ShubhamChinchane/Open-Science-Framework/README.md

# Open-Science-Framework
3D printed open source pipette with 4 nozzles
