ShubhamChinchane/Open-Science-Framework/Bill of materials.odt

Bill of materials

Part No. | Part Name | Quantity | Material | cost | Source
1 | Enclosure | 1 | PLA | 5$ | 3D printing Lab MTU
2 | Main Plunger | 1 | PLA | 4$ | 3D printing Lab MTU
3 | Syringe Holder | 1 | PLA | 5$ | 3D printing Lab MTU
4 | 1ml Syringe | 4 | Disposable plastic | 3.9$ | Allegromedical
5 | Compression Spring | 4 | Stainless steel | 2.5$ | Macmaster
6 | Female adaptor | 4 | Disposable Plastic | 1.8$ | Cole-Parmer Scientific experts
7 | universal pipette tips | 4 | Disposable Plastic | 0.5$ | Amazon
8 | Silicon medical tubing 3/16” OD | 1 foot | Silicon | 1.2$ | Freshwatersystems.com
9 | bolt | 1 | Stainless steel | 0.5$ | Macmaster
10 | Nut | 1 | Stainless steel | 0.5$ | Macmaster
Total cost = 24$

Links

- 1ml Syringe: https://www.allegromedical.com/syringes-c570/syringe-luer-lok-1cc-sp-p550722.html
- Compression Springs (part number: 9657K348): https://www.mcmaster.com/9657K348/
- Female Adapter for 1ml syringe: https://www.coleparmer.com/i/masterflex-fitting-polypropylene-straight-female-luer-to-hose-barb-adapter-1-8-id-25-pk/3080008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
- 300 μL universal pipette tips: https://www.amazon.com/Scientific-Universal-Pipette-Tips-Pack/dp/B07X3NYBJ1
- Silicon medical tubing 3/16” OD: https://www.freshwatersystems.com/products/silcon-medical-silicone-tubing-1-16-id-x-3-16-od-x-1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
- M3×35mm bolt (part number: 91287A026): https://www.mcmaster.com/91287A026/
- M3 Nut (part number: 90591A121): https://www.mcmaster.com/90591A121/
