ShubhamChinchane/Open-Science-Framework/4th_run_main_plunger.STL

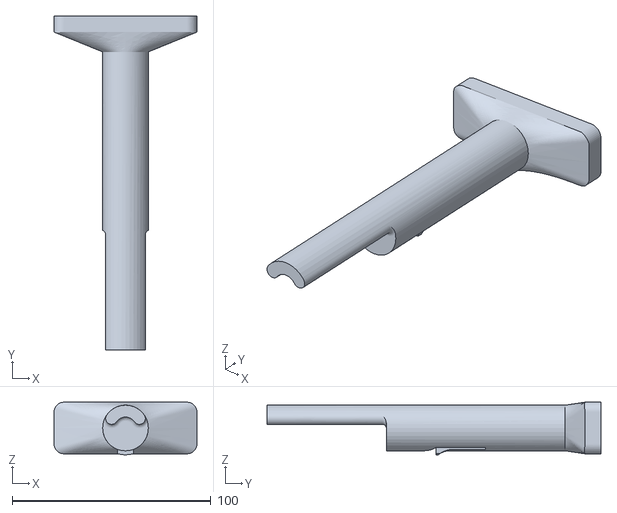
[picture p1: CAD file, 2020-12-15]
4th_run_main_plunger.STL
72.0 x 168.0 x 26.5
