ShubhamChinchane/Open-Science-Framework/main_plunger.SLDPRT

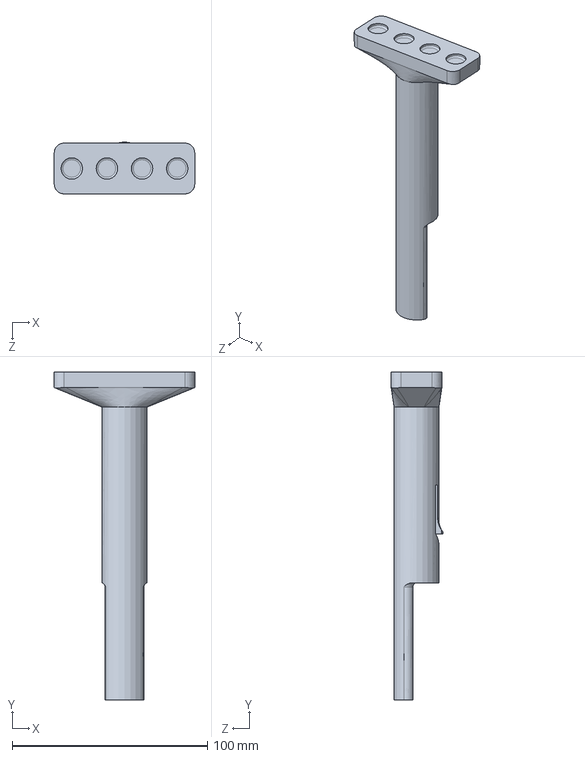
[picture p2: CAD file, 2020-12-15]
main_plunger.SLDPRT
72.0 x 168.0 x 26.5 mm
