ShubhamChinchane/Open-Science-Framework/4th_run_ enclosure_2.STL

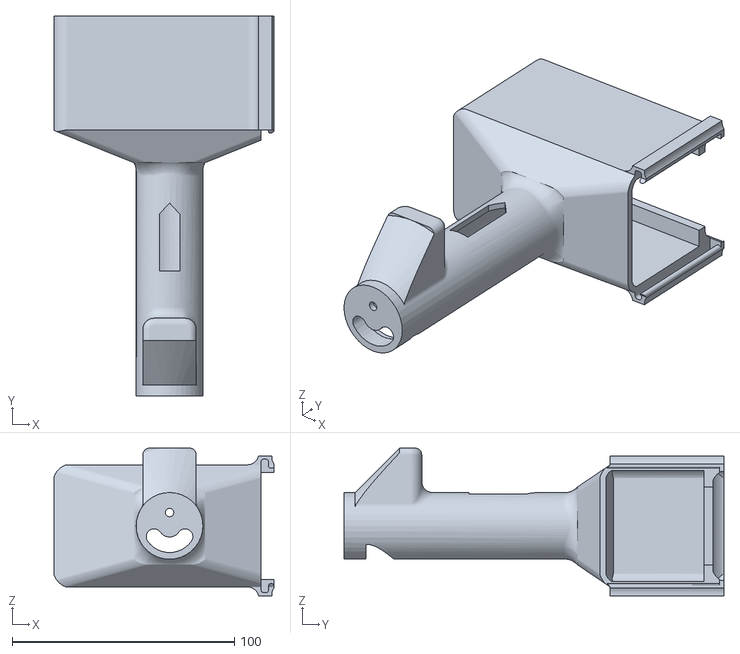
[picture p3: CAD file, 2020-12-15]
4th_run_ enclosure_2.STL
99.0 x 171.0 x 66.5
