ShubhamChinchane/Open-Science-Framework/Body1.SLDPRT

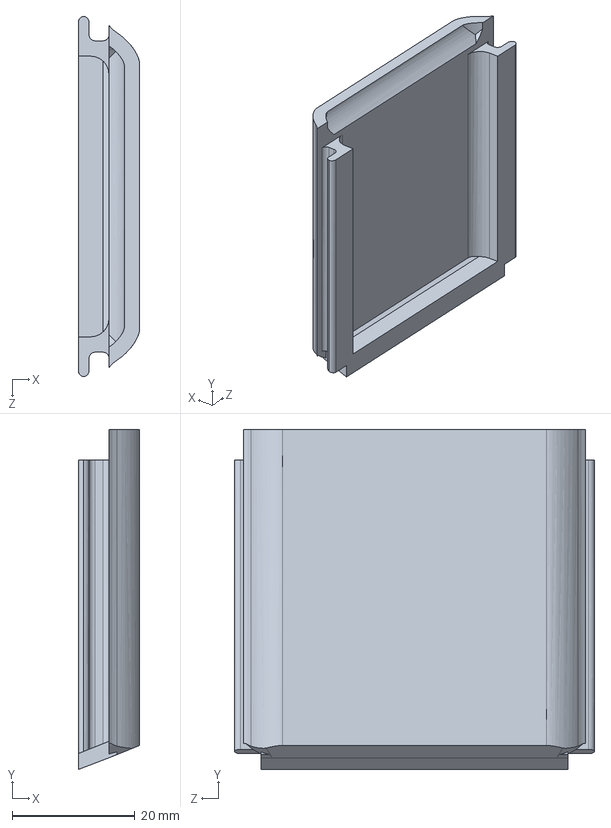
[picture p4: CAD file, 2020-12-15]
Body1.SLDPRT
10.0 x 55.4 x 58.7 mm
