ShubhamChinchane/Open-Science-Framework/plunger.FCStd

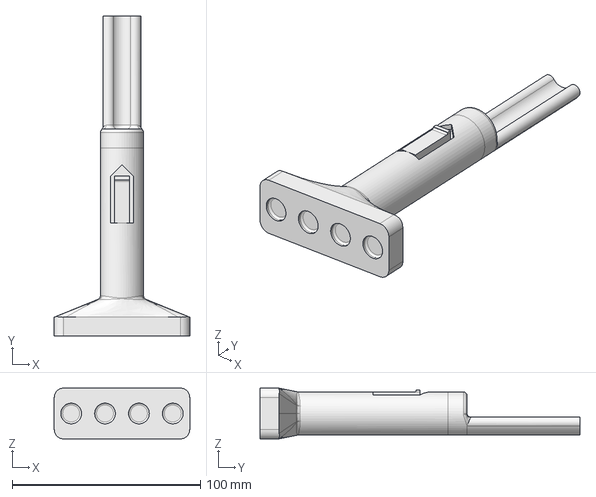
[picture p5: CAD file, 2020-12-15]
plunger.FCStd
72.0 x 170.0 x 27.0 mm
