ShubhamChinchane/Open-Science-Framework/4th_run_syringeholder.STL

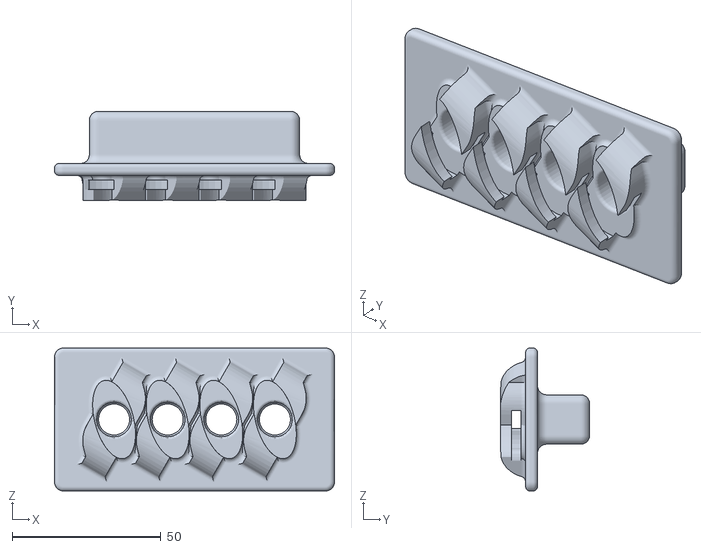
[picture p6: CAD file, 2020-12-15]
4th_run_syringeholder.STL
94.0 x 30.0 x 48.0
