ShubhamChinchane/Open-Science-Framework/(list of files, cad)

Other CAD files:
4 syringe holder.SLDPRT
Enclosure_part-2.FCStd
4th_run_enclosure_1.STL
Enclosure_part-1.FCStd
Body2.SLDPRT
