ShubhamChinchane/Open-Science-Framework/Validation.xlsx

Set Volume of 200 µL
 | Channel 1 |  | Channel 2 |  | Channel 3 |  | Channel 4
Sr No | Weight (mg) | Volume (µL) | Weight (mg) | Volume (µL) | Weight (mg) | Volume (µL) | Weight (mg) | Volume (µL)
1 | 203 | 203.5075 | 201 | 201.5025 | 202 | 202.505 | 202 | 202.505
2 | 204 | 204.51 | 201 | 201.5025 | 200 | 200.5 | 202 | 202.505
3 | 203 | 203.5075 | 200 | 200.5 | 203 | 203.5075 | 202 | 202.505
4 | 204 | 204.51 | 200 | 200.5 | 203 | 203.5075 | 203 | 203.5075
5 | 203 | 203.5075 | 201 | 201.5025 | 201 | 201.5025 | 202 | 202.505
6 | 203 | 203.5075 | 202 | 202.505 | 199 | 199.4975 | 203 | 203.5075
7 | 204 | 204.51 | 202 | 202.505 | 201 | 201.5025 | 202 | 202.505
8 | 204 | 204.51 | 201 | 201.5025 | 202 | 202.505 | 203 | 203.5075
9 | 203 | 203.5075 | 202 | 202.505 | 201 | 201.5025 | 202 | 202.505
10 | 203 | 203.5075 | 200 | 200.5 | 201 | 201.5025 | 202 | 202.505
 | Average: | 203.9085 | Average: | 201.5025 | Average: | 201.80325 | Average: | 202.80575
Set Volume of 100 µL
 | Channel 1 |  | Channel 2 |  | Channel 3 |  | Channel 4
Sr No | Weight (mg) | Volume (µL) | Weight (mg) | Volume (µL) | Weight (mg) | Volume (µL) | Weight (mg) | Volume (µL)
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
